RDAsaBranca/OperacaoSpaceWeek/Documentos/Especificação de Carga/vista modelo seção.pdf

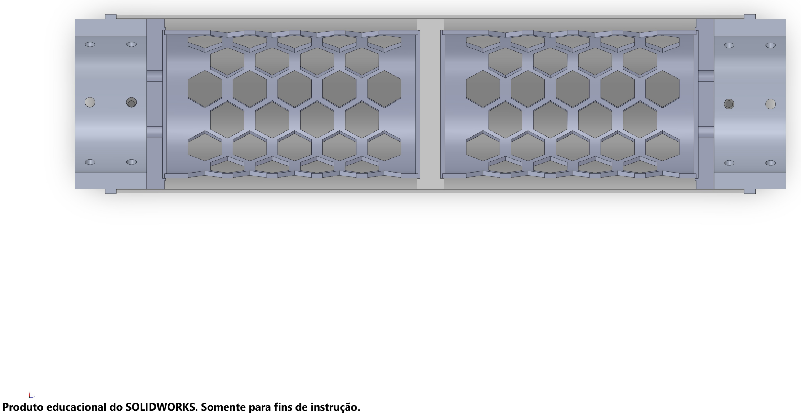
[picture p5: page 1]

Produto educacional do SOLIDWORKS. Somente para fins de instrução.
