RDAsaBranca/OperacaoSpaceWeek/Documentos/Especificação de Carga/vista modelo.pdf

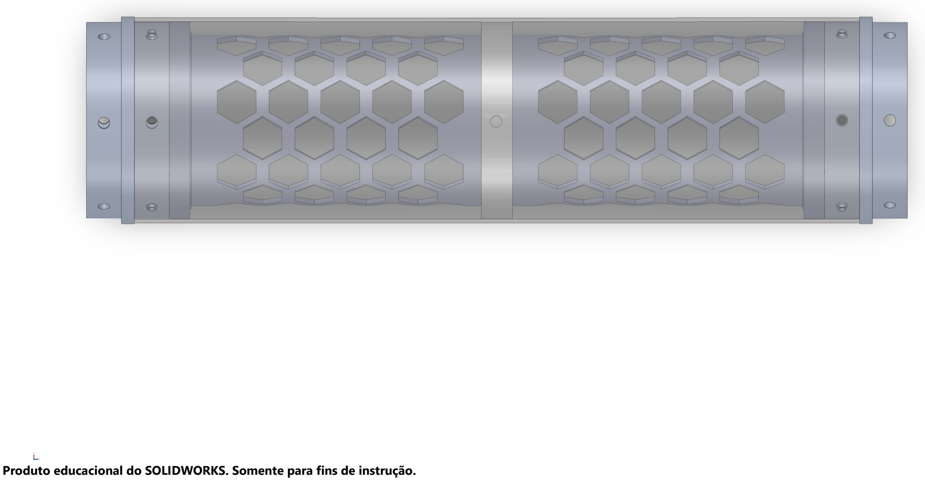
[picture p6: page 1]

Produto educacional do SOLIDWORKS. Somente para fins de instrução.
