RDAsaBranca/OperacaoSpaceWeek/Documentos/EPS/134N3P.png

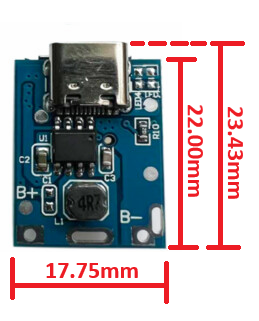
Documentos/EPS/134N3P.png
