RDAsaBranca/OperacaoSpaceWeek/Documentos/OBDH/BMP280_module5V_layout.png

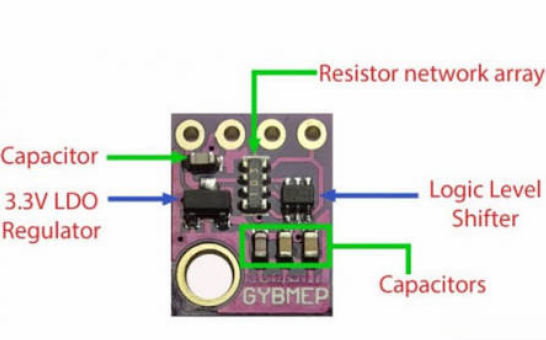
Documentos/OBDH/BMP280_module5V_layout.png
