RDAsaBranca/OperacaoSpaceWeek/Documentos/OBDH/BMP280_module.png

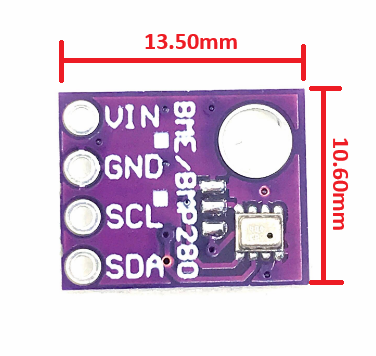
Documentos/OBDH/BMP280_module.png
