RDAsaBranca/OperacaoSpaceWeek/Documentos/OBDH/BNO055_module.png

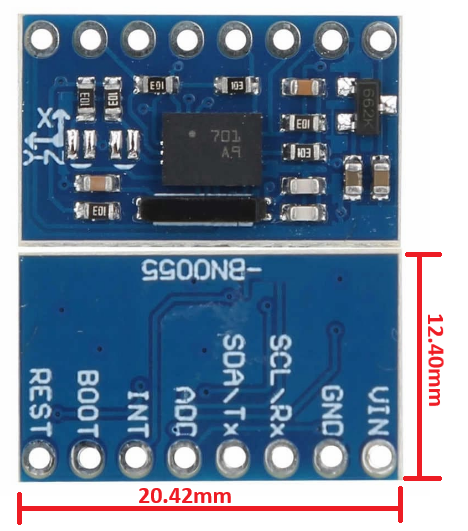
Documentos/OBDH/BNO055_module.png
