RDAsaBranca/OperacaoSpaceWeek/Documentos/OBDH/ESP32C3_Supermini_board.png

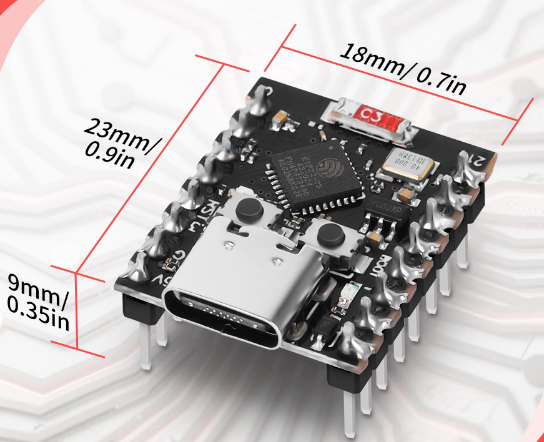
Documentos/OBDH/ESP32C3_Supermini_board.png
