RDAsaBranca/OperacaoSpaceWeek/Documentos/OBDH/GY-NEO6MV2_RedBoard.png

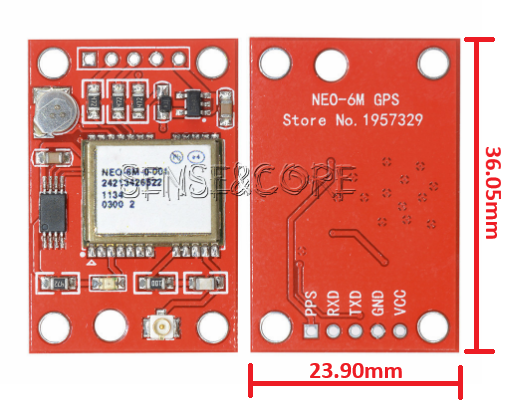
Documentos/OBDH/GY-NEO6MV2_RedBoard.png
