RDAsaBranca/OperacaoSpaceWeek/Documentos/OBDH/W25Q128_module.png

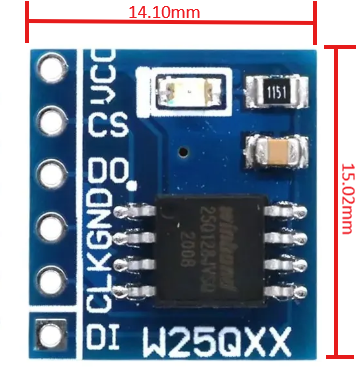
Documentos/OBDH/W25Q128_module.png
