RDAsaBranca/OperacaoSpaceWeek/Documentos/TT&C/SX1276_SMD_module.png

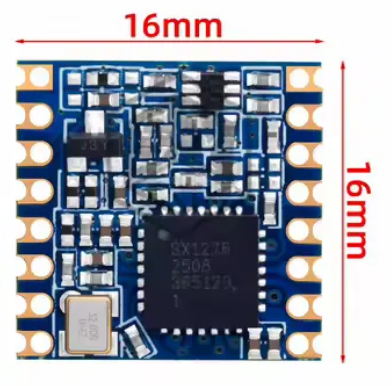
Documentos/TT&C/SX1276_SMD_module.png
