RDAsaBranca/OperacaoSpaceWeek/Documentos/Especificação de Carga/travaCentral.STEP

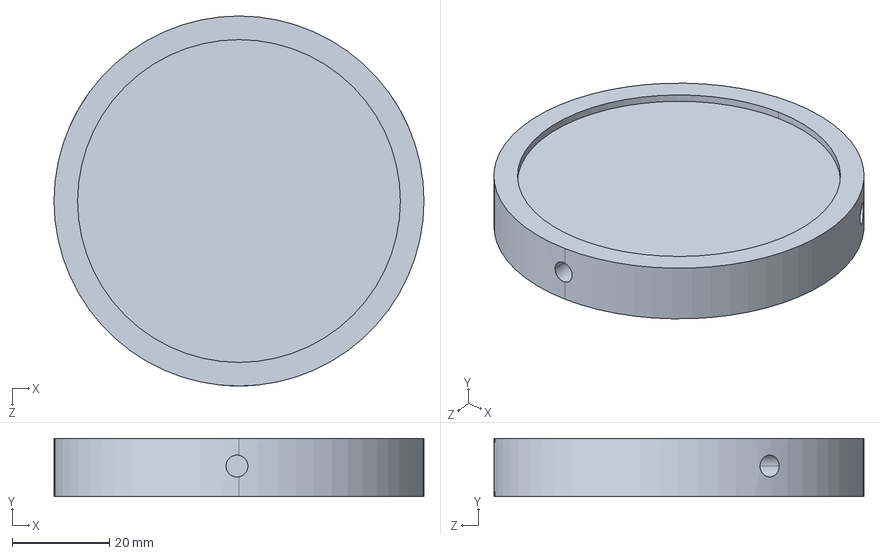
[picture p15: CAD file, 2026-10-11]
Documentos/Especificação de Carga/travaCentral.STEP
76.0 x 12.0 x 76.0 mm
