RDAsaBranca/OperacaoSpaceWeek/Estrutura/cansat (com case de bateria e furos para a placa).step

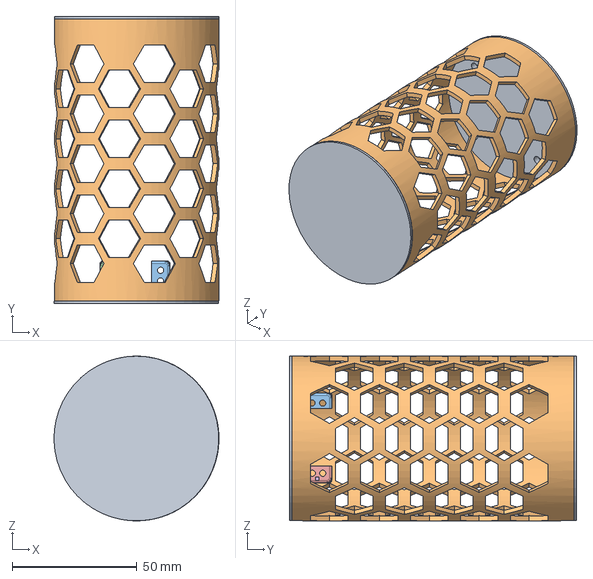
[picture p16: CAD file, 2026-11-09]
Estrutura/cansat (com case de bateria e furos para a placa).step
66.1 x 115.0 x 66.0 mm
simulacro cansat tampa x 2
simulacro cansat corpo
