RDAsaBranca/OperacaoSpaceWeek/Documentos/Especificação de Carga/Trava da base.STEP

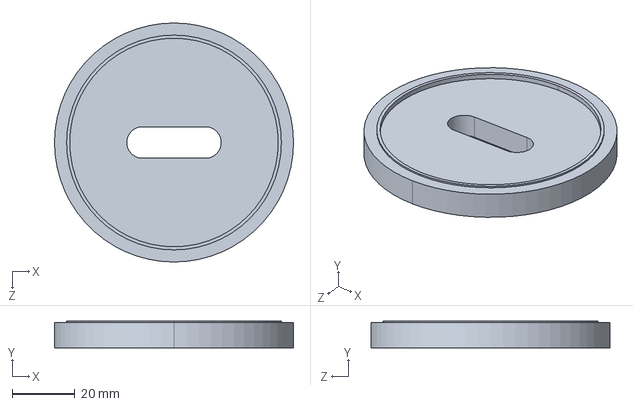
[picture p17: CAD file, 2026-10-11]
Documentos/Especificação de Carga/Trava da base.STEP
76.0 x 8.50 x 76.0 mm
