RDAsaBranca/OperacaoSpaceWeek/Estrutura/montagem cansatFake.STEP

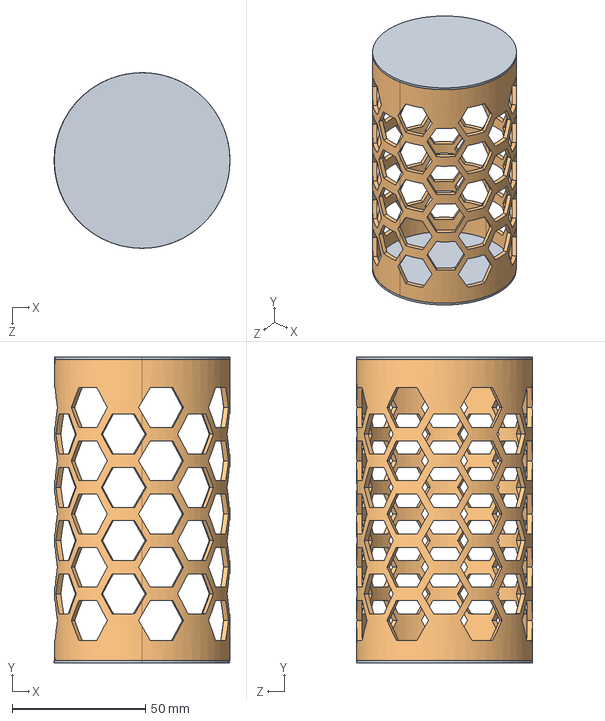
[picture p18: CAD file, 2026-10-11]
Estrutura/montagem cansatFake.STEP
66.1 x 115.0 x 66.0 mm
simulacro cansat tampa x 2
simulacro cansat corpo
