RDAsaBranca/OperacaoSpaceWeek/Documentos/Especificação de Carga/Anel Acoplador - 3DA.STEP

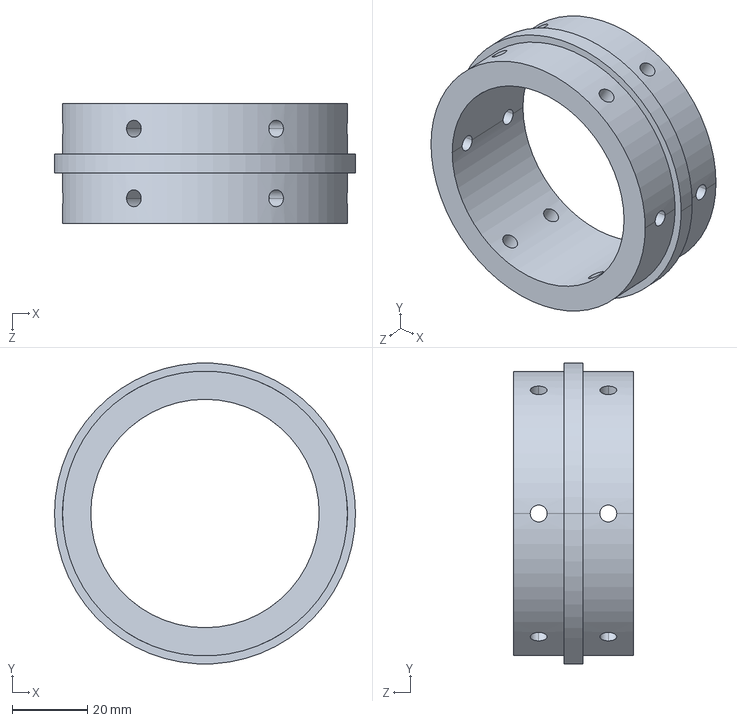
[picture p19: CAD file, 2026-10-11]
Documentos/Especificação de Carga/Anel Acoplador - 3DA.STEP
80.0 x 79.9 x 32.0 mm
