RDAsaBranca/OperacaoSpaceWeek/Documentos/Especificação de Carga/Erippus-B.STEP

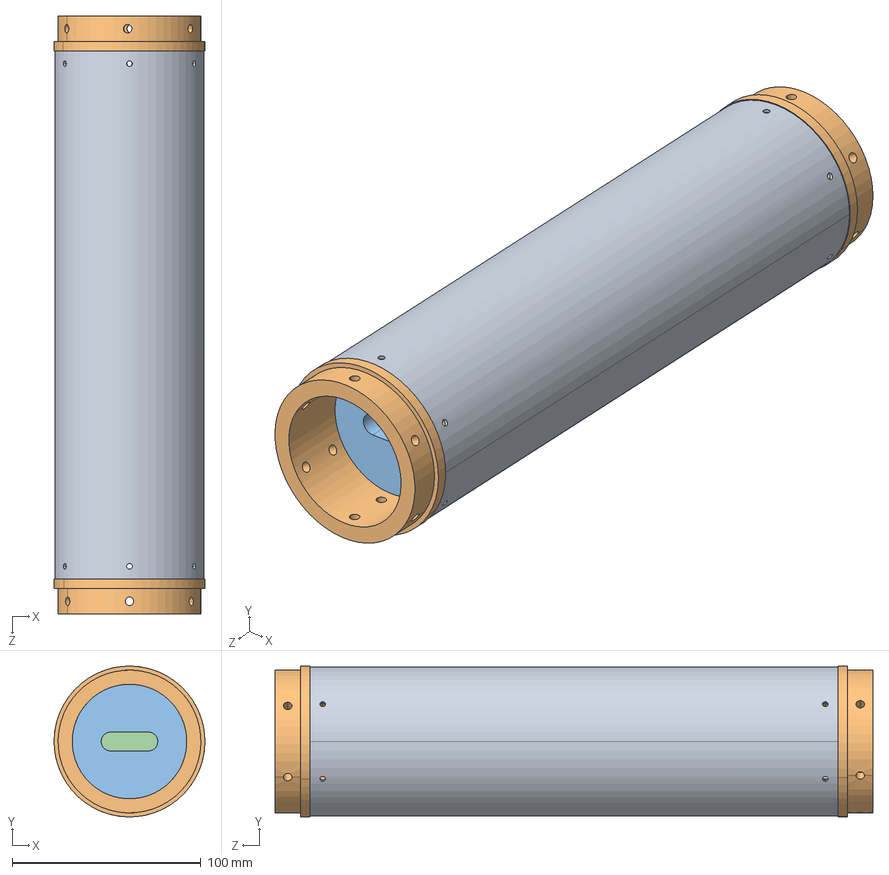
[picture p20: CAD file, 2026-10-11]
Documentos/Especificação de Carga/Erippus-B.STEP
80.0 x 80.0 x 317.0 mm
Tubo do Payload
Anel Acoplador - 3DA x 2
Trava da base x 2
simulacro cansat tampa x 4
simulacro cansat corpo x 2
travaCentral
