RDAsaBranca/OperacaoSpaceWeek/Documentos/Especificação de Carga/Tubo do Payload.STEP

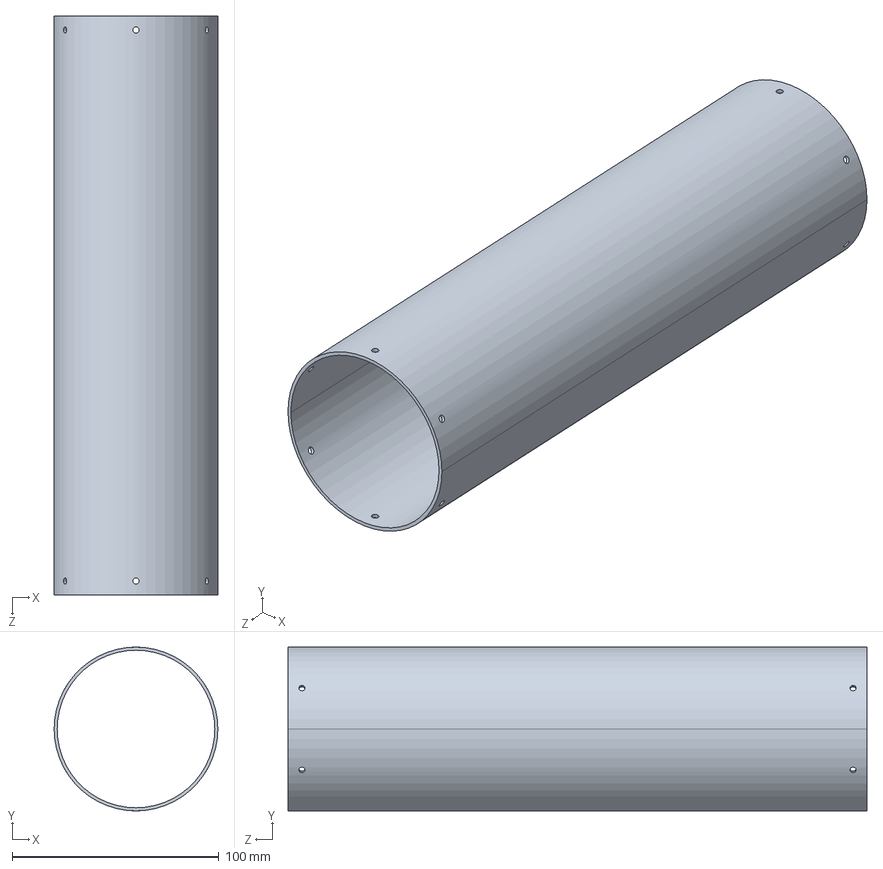
[picture p21: CAD file, 2026-10-11]
Documentos/Especificação de Carga/Tubo do Payload.STEP
79.2 x 79.2 x 280.0 mm
