RDAsaBranca/OperacaoSpaceWeek/(list of files, cad)

Other CAD files:
Estrutura/cansat (com case de bateria e furos para a placa).stl
