RDAsaBranca/OperacaoSpaceWeek/Documentos/telemetria/src/base/dashboard_html.h

// GERADO AUTOMATICAMENTE a partir de web/dashboard.html
// Nao edite aqui: edite o HTML e compile de novo.
#pragma once
#include <Arduino.h>

// 40371 bytes de HTML -> 12644 bytes com gzip
static const size_t DASHBOARD_HTML_GZ_LEN = 12644;
static const uint8_t DASHBOARD_HTML_GZ[] PROGMEM = {
  0x1F, 0x8B, 0x08, 0x00, 0x00, 0x00, 0x00, 0x00, 0x02, 0x03, 0xB5, 0x7D, 0xDB, 0x72, 0x1B, 0x49, 0xB2, 0xD8, 0xBB, 0xBE,
  0xA2, 0xC4, 0xD9, 0x1D, 0x74, 0x0F, 0x81, 0x26, 0x00, 0x5E, 0x44, 0x81, 0x17, 0x1D, 0x52, 0xA2, 0x34, 0x5A, 0x8F, 0x2E,
  0x16, 0x35, 0x37, 0xF3, 0x30, 0x18, 0x4D, 0xA0, 0x00, 0xF6, 0xB0, 0xD1, 0x8D, 0xE9, 0x6E, 0x80, 0xA4, 0x74, 0xE4, 0x38,
  0x4F, 0x0E, 0xBF, 0xDA, 0xE1, 0x27, 0x3F, 0x79, 0xEC, 0x08, 0x6F, 0xF8, 0xE1, 0x44, 0x6C, 0xC4, 0xF1, 0x93, 0x1F, 0x57,
  0x7F, 0xB2, 0x5F, 0xE2, 0xBC, 0x54, 0x55, 0x57, 0x35, 0x1A, 0x20, 0xB4, 0xBB, 0x47, 0x0F, 0x22, 0x50, 0x97, 0xAC, 0xAC,
  0xAC, 0xCC, 0xAC, 0xCC, 0xAC, 0xAC, 0xC2, 0xFE, 0xC3, 0x41, 0xDA, 0x2F, 0xEE, 0x26, 0x52, 0x5C, 0x15, 0xE3, 0xF8, 0xF0,
  0xC1, 0x3E, 0xFE, 0x11, 0x71, 0x98, 0x8C, 0x0E, 0xD6, 0x26, 0x45, 0xEB, 0xF8, 0xDD, 0x1A, 0x96, 0xC9, 0x70, 0x00, 0x7F,
  0xC6, 0xB2, 0x08, 0x45, 0xFF, 0x2A, 0xCC, 0x72, 0x59, 0x1C, 0xAC, 0x4D, 0x8B, 0x61, 0x6B, 0x77, 0x4D, 0x17, 0x27, 0xE1,
  0x58, 0x1E, 0xAC, 0xCD, 0x22, 0x79, 0x33, 0x49, 0xB3, 0x62, 0x4D, 0xF4, 0xD3, 0xA4, 0x90, 0x09, 0x34, 0xBB, 0x89, 0x06,
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
  0xA6, 0xBF, 0x0C, 0xFB, 0xD7, 0xA3, 0x2C, 0x9D, 0x26, 0x83, 0x9E, 0x98, 0x85, 0x99, 0xA7, 0x56, 0xCB, 0x37, 0x4C, 0xA0,
  0x8B, 0x89, 0xC0, 0x54, 0x3C, 0x04, 0x1D, 0x01, 0x60, 0xB7, 0x27, 0xB7, 0x1B, 0x9D, 0x60, 0x6B, 0x5B, 0xD5, 0x13, 0xD3,
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
};
