RDAsaBranca/OperacaoSpaceWeek/Documentos/telemetria/src/base/saida.cpp

#include "saida.h"
#include <Arduino.h>
#include <math.h>

static const float BATERIA_BAIXA_V = 3.5f;  // NCR18650B: ~3,6 V nominal, 4,2 V cheia

void saidaCabecalho() {
  Serial.println("# === ESTACAO BASE: telemetria LoRa SX1276 ===");
  Serial.printf("# colunas TLM: %s,rssi_dbm,snr_db,perdidos\n", TLM_COLUNAS);
}

void saidaCsv(const PacoteTelemetria& p, float rssi, float snr, uint32_t perdidos) {
  char linha[320];
  pacoteParaCsv(p, linha, sizeof(linha));
  Serial.printf("TLM,%s,%.1f,%.2f,%lu\n", linha, rssi, snr, (unsigned long)perdidos);
}

// Quaternion -> angulos de Euler (rolagem, arfagem, guinada) em graus
static void quaternionParaEuler(const PacoteTelemetria& p, float& rol, float& arf, float& gui) {
  const float w = p.quat[0] / QUAT_ESCALA, x = p.quat[1] / QUAT_ESCALA;
  const float y = p.quat[2] / QUAT_ESCALA, z = p.quat[3] / QUAT_ESCALA;
  const float RAD = 57.2957795f;
  rol = atan2f(2.0f * (w * x + y * z), 1.0f - 2.0f * (x * x + y * y)) * RAD;
  float s = 2.0f * (w * y - z * x);
  if (s > 1.0f) s = 1.0f;
  if (s < -1.0f) s = -1.0f;
  arf = asinf(s) * RAD;
  gui = atan2f(2.0f * (w * z + x * y), 1.0f - 2.0f * (y * y + z * z)) * RAD;
  if (gui < 0) gui += 360.0f;
}

void saidaLegivel(const PacoteTelemetria& p, float rssi, float snr,
                  uint32_t recebidos, uint32_t perdidos) {
  const uint32_t total = recebidos + perdidos;
  const float perda = total ? 100.0f * perdidos / total : 0.0f;
  const bool fix = p.status & STATUS_GPS_FIX;
  const float bateria = p.bateriaMv / 1000.0f;

  Serial.printf(
      "# [%s] alt %.1f m (max %.1f) v %+.1f m/s | GPS %s %u sats %.7f,%.7f | "
      "bat %.2f V | RSSI %.0f dBm SNR %.1f dB | perda %.1f%%\n",
      nomeEstado(p.estado), p.altitudeCm / 100.0f, p.altMaxCm / 100.0f,
      p.velVertDms / 10.0f, fix ? "fix" : "SEM FIX", p.satelites,
      p.latE7 / 1e7, p.lonE7 / 1e7, bateria, rssi, snr, perda);

  const unsigned c = p.calibracao;
  if (p.status & STATUS_ORIENT_OK) {
    float rol, arf, gui;
    quaternionParaEuler(p, rol, arf, gui);
    Serial.printf("#    orientacao rol %+.1f arf %+.1f gui %.1f graus | calibracao BNO055 S%u G%u A%u M%u (0..3)\n",
                  rol, arf, gui, (c >> 6) & 3u, (c >> 4) & 3u, (c >> 2) & 3u, c & 3u);
  }

  if (!(p.status & STATUS_BARO_OK)) Serial.println("# [ALERTA] barometro BMP280 com falha");
  if (!(p.status & STATUS_IMU_OK))  Serial.println("# [ALERTA] IMU BNO055 com falha");
  if (p.status & STATUS_FLASH_CHEIA) Serial.println("# [ALERTA] flash W25Q128 cheia, gravacao parada");
  else if (!(p.status & STATUS_FLASH_OK)) Serial.println("# [ALERTA] foguete NAO esta gravando na flash");
  if (bateria < BATERIA_BAIXA_V) Serial.printf("# [ALERTA] bateria baixa: %.2f V\n", bateria);
}
