RDAsaBranca/OperacaoSpaceWeek/Documentos/telemetria/src/foguete/log.h

// log.h - mensagens de diagnostico pela USB, desligaveis para o voo
#pragma once
#include <Arduino.h>

#ifndef DEBUG_SERIAL
#define DEBUG_SERIAL 1
#endif

#if DEBUG_SERIAL
  #define LOG(...) Serial.printf(__VA_ARGS__)
#else
  // Desligado: o compilador descarta a chamada, mas continua conferindo o formato
  #define LOG(...) do { if (0) Serial.printf(__VA_ARGS__); } while (0)
#endif
