RDAsaBranca/OperacaoSpaceWeek/(commit log)

2026-10-12 Mudança do SX1278 para o SX1276
2026-10-31 feat: estrutura inicial do projeto de telemetria
2026-10-31 feat: atualização da estação base(add de dashboard e simplificação do código)
2026-11-06 Gerber da PCB e documentos locais do projeto e PCB V1_7 do EasyEDA
    [Drill_NPTH_Through.DRL, Drill_PTH_Through.DRL, Gerber_BoardOutlineLayer.GKO, Gerber_BottomLayer.GBL, Gerber_BottomPasteMaskLayer.GBP, Gerber_BottomSilkscreenLayer.GBO, Gerber_BottomSolderMaskLayer.GBS, Gerber_TopLayer.GTL]
2026-11-06 Mudanças na PCB
    [Drill_NPTH_Through.DRL, Drill_PTH_Through.DRL, Gerber_BoardOutlineLayer.GKO, Gerber_BottomLayer.GBL, Gerber_BottomPasteMaskLayer.GBP, Gerber_BottomSilkscreenLayer.GBO, Gerber_BottomSolderMaskLayer.GBS, Gerber_TopLayer.GTL]
2026-11-07 Estrutura Base para o Cansat
    basicamente foi criado uma estrutura para a spaceweek pelo pessoal da organização e eu só fiz o trabalho de comportar a bateria. ainda não sei se falta mais algo, mas suponho que irei procurar um modo de comportar parafusos
    [cansat (com case de bateria e furos para a placa).stl]
2026-11-09 Step
    só adicionei o step do mesmo modelo
    [cansat (com case de bateria e furos para a placa).step, montagem cansatFake.STEP]
2026-11-09 CORPOSTEP
    eu esqueci o corpo no último push... 🥀🥀
    [cansat (com case de bateria e furos para a placa).step]
